mkalkowski83/floor-heating/README.md

# floor-heating

Sterowanie ogrzewaniem podłogowym (ESPHome + Home Assistant), moduł przy rozdzielaczach.

## Dokumenty

- Design: [`docs/superpowers/specs/2026-10-30-floor-heating-manifold-design.md`](docs/superpowers/specs/2026-10-30-floor-heating-manifold-design.md)
- Schemat i legenda: [`docs/README-schemat.pl.md`](docs/README-schemat.pl.md) · [PDF](docs/floor-heating-manifold.pdf)
- **BOM (lokalnie):** [`docs/bom/floor-heating-manifold-phase1.xlsx`](docs/bom/floor-heating-manifold-phase1.xlsx) — przenieś na Dysk Google i ewentualnie „Zapisz jako Arkusz Google”
- BOM CSV (opcjonalnie): [`docs/bom/floor-heating-manifold-phase1.csv`](docs/bom/floor-heating-manifold-phase1.csv)
