mkalkowski83/floor-heating/docs/bom/floor-heating-manifold-phase1.csv

Lp | Kategoria | Element | Spec / uwagi | Ilość | Jedn. | Faza | Status | Szac. cena (PLN) | Link / sklep | Uwagi
1 | Sterowanie | ESP32 DevKit V1 | U1. VIN z +5 V płytki AC. GPIO 16, 17, 18, 19, 21, 22, 23, 25 = zawory; 26 = pompa; 27 = HD; 4 = 1-Wire. | 1 | szt. | kupiony | kupiony |  |  | Aktywne LOW. Przy programowaniu nie łączyć USB z +5 V HLK.
2 | Sterowanie | Moduł 8 przekaźników 5 V | U2. Optoizolacja, zworka JD-VCC–VCC do zdjęcia. Styki NO 10 A. K1–K8 siłowniki 230 V NC. | 1 | szt. | kupić | do zakupu |  |  | VCC przy IN = 3,3 V z ESP. Cewki z +5 V (JD-VCC).
3 | Sterowanie | Moduł 2 przekaźniki 5 V | U3. Ten sam typ co U2. K9 pompa (rezerwa), K10 suchy styk RT. | 1 | szt. | kupić | do zakupu |  |  | K10 bez 230 V. Nie używać Burner off.
4 | Zasilanie AC | HLK-10M05 | PS1. 5 V / 2 A / 10 W, 85–264 V AC. | 1 | szt. | kupiony | kupiony |  |  | Nie HLK-PM01 (3 W) i nie HLK-2M05 ze szamba — za mało prądu na 10 cewek.
5 | Zasilanie AC | Bezpiecznik T1A zwłoczny + oprawka | F1. Tylko tor HLK, przed modułem. | 1 | kpl. | kupić | do zakupu |  |  | Odpowiednik F1 (~1 A) z płytki AC w szambie.
6 | Zasilanie AC | Warystor MOV, L–N | Na płytce AC, równolegle do wejścia HLK. 275 V AC, typowo 10D471K albo 14D471K. | 1 | szt. | kupić | do zakupu |  |  | Jak RV1 w tank-level-mains. Na schemacie podłogówki jeszcze go nie ma.
7 | Zasilanie AC | Zacisk śrubowy 2P, L/N | Wejście płytki AC. | 1 | szt. | kupić | do zakupu |  |  | Jak J1 na płytce AC w szambie. To wejście 230 V modułu.
8 | Zasilanie AC | Zacisk śrubowy 2P, +5 V / GND | Wyjście płytki AC: VIN ESP oraz JD-VCC obu modułów przekaźników. | 1 | szt. | kupić | do zakupu |  |  | Jak J2 w szambie. GND logiki nie łączyć z N sieci.
9 | Zasilanie AC | Płytka uniwersalna AC | Osobna od logiki. Odstępy sieciowe tylko na tej płytce. | 1 | szt. | kupić | do zakupu |  |  | Układ jak w szambie: L/N → F1 → MOV → HLK-10M05 → +5 V/GND.
10 | Zasilanie AC | Kondensator ceramiczny 100 nF / 50 V | Osiowy, monolityczny. C1 przy +5 V/GND wyjścia HLK (PS1), C2 przy VIN ESP (U1). Nie X2 — tylko 5 V. | 2 | szt. | kupić | do zakupu |  | https://allegro.pl/oferta/kondensator-monolityczny-100nf-50v-osiowy-10szt-12324094122 | Paczka 10 szt. na Allegro. Nie pod 230 V / nie kondensator X2.
11 | Obciążenie | Bezpiecznik T2A zwłoczny + oprawka | F2. Faza L_OBC siłowników i pompy. | 1 | kpl. | kupić | do zakupu |  |  | Nie zasila HLK.
12 | Obciążenie | Listwa N_OBC, 9 pól + mostek | J12–J19: kabel do pinu 2 ZAW1–ZAW8. J20: kabel do pinu 2 pompy. Drugi biegun pól zwarty w jedną linię N_OBC. | 1 | kpl. | kupić | do zakupu |  |  | Neutral z wejścia 230 V.
13 | Obciążenie | Listwa L_OBC, 9 pól + mostek | J21–J28: kabel na COM K1–K8. J29: kabel na COM K9. Drugi biegun pól zwarty w jedną linię L_OBC. | 1 | kpl. | kupić | do zakupu |  |  | K10 (RT) nie wchodzi na tę listwę.
14 | Obciążenie | Zacisk śrubowy 2P siłownika | J2–J9. Pin 1 = styk NO przekaźnika, pin 2 = kabel do listwy N. | 8 | szt. | kupić | do zakupu |  |  | W fazie 1 podłączone 3–4 pętle; zaciski od razu pod 8.
15 | Obciążenie | Zacisk śrubowy 2P pompy | J10. Pin 1 = NO K9, pin 2 = listwa N. | 1 | szt. | kupić | do zakupu |  |  | Samej pompy i sprzęgła nie kupować w fazie 1.
16 | Obciążenie | Zacisk śrubowy 2P RT | J11. Suchy styk NO–COM na zacisk RT kotła VC 15CS/1-5. | 1 | szt. | kupić | do zakupu |  |  | Bez 230 V. Nie Burner off.
17 | Siłowniki | Siłownik termoelektryczny 230 V NC | Gwint jak na rozdzielaczu (często M30×1.5). NC: zasilony = zawór otwarty. | 4 | szt. | kupić | do zakupu |  |  | Docelowo do 8.
18 | Przyłącza | Kabel HD → Vaillant | Suchy styk modułu na zacisk RT. | 1 | kpl. | kupić | do zakupu |  |  | eBUS zostaje głównym żądaniem ciepła.
19 | Przyłącza | Przewody, tulejki, oznaczniki | 230 V: 0,75–1,5 mm². +5 V i 1-Wire: cieńszy przewód. Tulejki i numerki. | 1 | kpl. | kupić | do zakupu
20 | Obudowa | Obudowa modułu | Mieści płytkę AC z HLK i część logiczną. HLK w zamkniętej części obudowy. | 1 | szt. | kupić | do zakupu |  |  | Zapas na listwy L/N i 1-Wire.
21 | Temperatura | DS18B20, sonda Ø ~6 mm | U4 zasilanie rozdzielacza, U5 powrót. Przewód 1–2 m. | 2 | szt. | kupić | do zakupu |  |  | Montaż przylgowy na belkach.
22 | Temperatura | Montaż przylgowy | Opaski, pasta termoprzewodząca, izolacja. | 2 | kpl. | kupić | do zakupu |  |  | Bazowy montaż.
23 | Temperatura | Rezystor 4,7 kΩ | R1. Pull-up magistrali 1-Wire do 3,3 V. | 1 | szt. | kupić | do zakupu
24 | Instalacja | RCBO obwodu modułu | 1P+N, 30 mA typ A, prąd znamionowy wg elektryka. W rozdzielnicy, nie na płytce AC. | 1 | szt. | kupić | do ustalenia |  |  | Nie zastępuje F1 ani F2.
25 | Temperatura (opcja) | Tuleja zanurzeniowa G½″ | Ø 7–8 mm, L 100–120 mm. Gwint potwierdzić na rozdzielaczu. | 2 | szt. | opcjonalnie | opcja A |  |  | Zamiast montażu przylgowego.
26 | Temperatura (opcja) | Redukcja gwintu | Gdy korek belki nie jest G½″. | 0 | szt. | opcjonalnie | wg rozdzielacza
27 | Temperatura (opcja) | Zachowanie spustu belki | Trójnik albo drugi spust, jeśli tuleja zajmuje jedyny. | 0 | kpl. | opcjonalnie | wg rozdzielacza
28 | Rezerwa | Pompa wtórna i sprzęgło | Kanał K9, J10 i J29 są na liście. Samej pompy nie kupować. | 0 | — | nie kupować | n/d |  |  | Osobna decyzja z hydraulikiem.
29 | Out | Zigbee na sterowniku | Odrzucone. Moduł jest na Wi-Fi, sieć IoT bez WAN. | 0 | — | nie kupować | nie kupować
30 | Docelowo | Moduł dół | Kopia pozycji kupowanych dla modułu góra, łącznie z płytką AC. | 0 | — | odłożone | odłożone
