mkalkowski83/floor-heating/docs/floor-heating-manifold.pdf

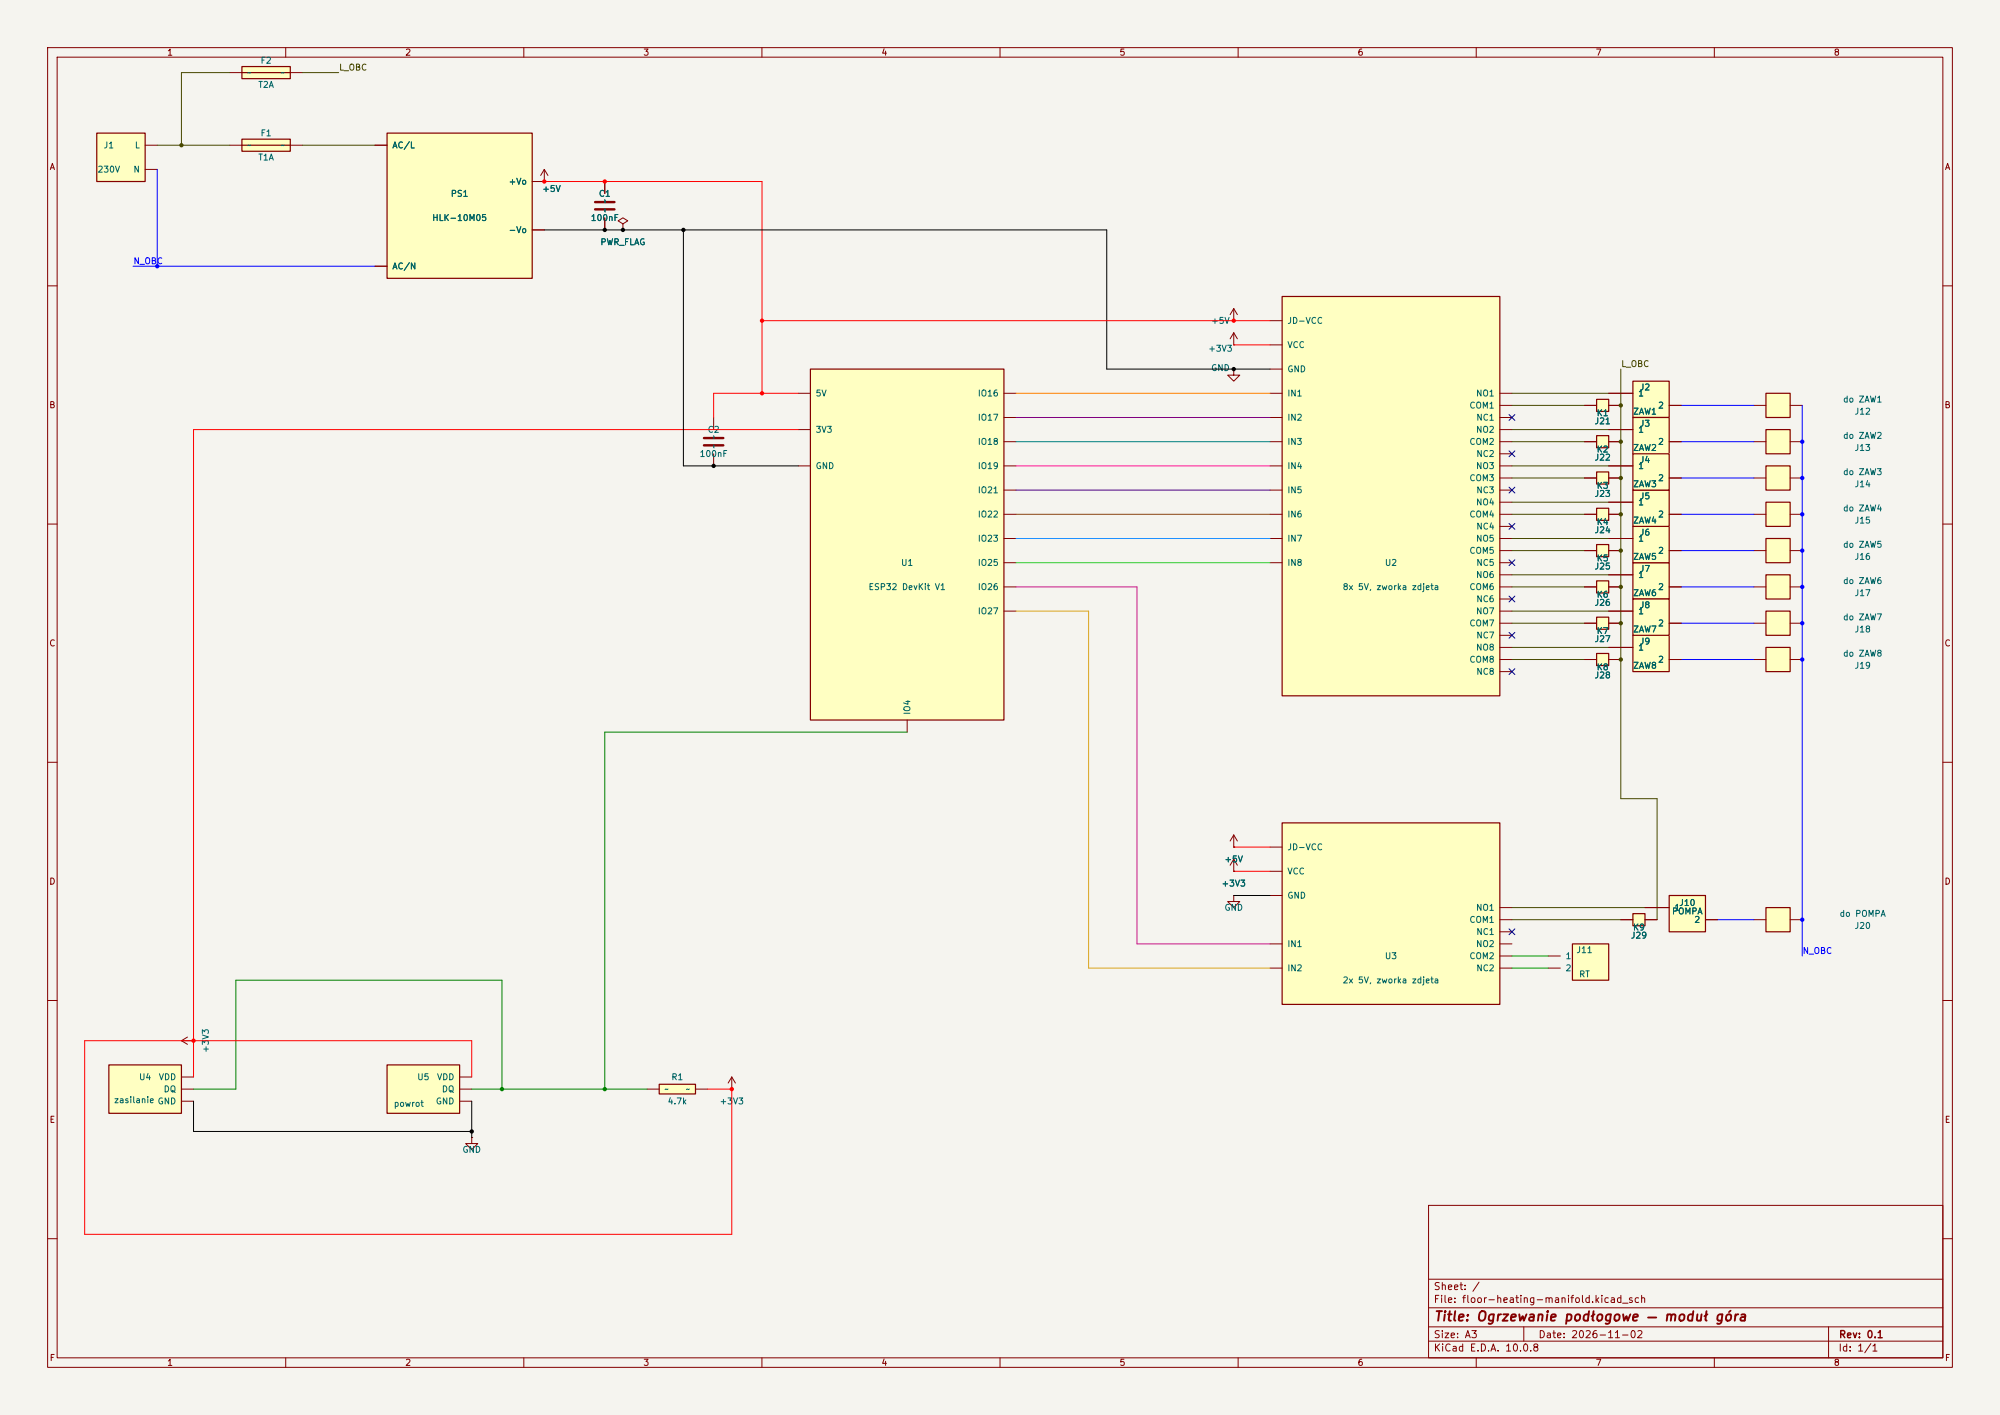
[picture p1: page 1]

File: floor-heating-manifold.kicad_sch
Title: Ogrzewanie podłogowe — moduł góra

Size: A3 | Rev: 0.1 | F Date: 2026-11-02
KiCad E.D.A. 10.0.8 | Id: 1/1
