mkalkowski83/floor-heating/docs/kicad/floor-heating-manifold/floor-heating-manifold.kicad_sch

## KiCad design docs/kicad/floor-heating-manifold/floor-heating-manifold.kicad_sch (2026-11-10)

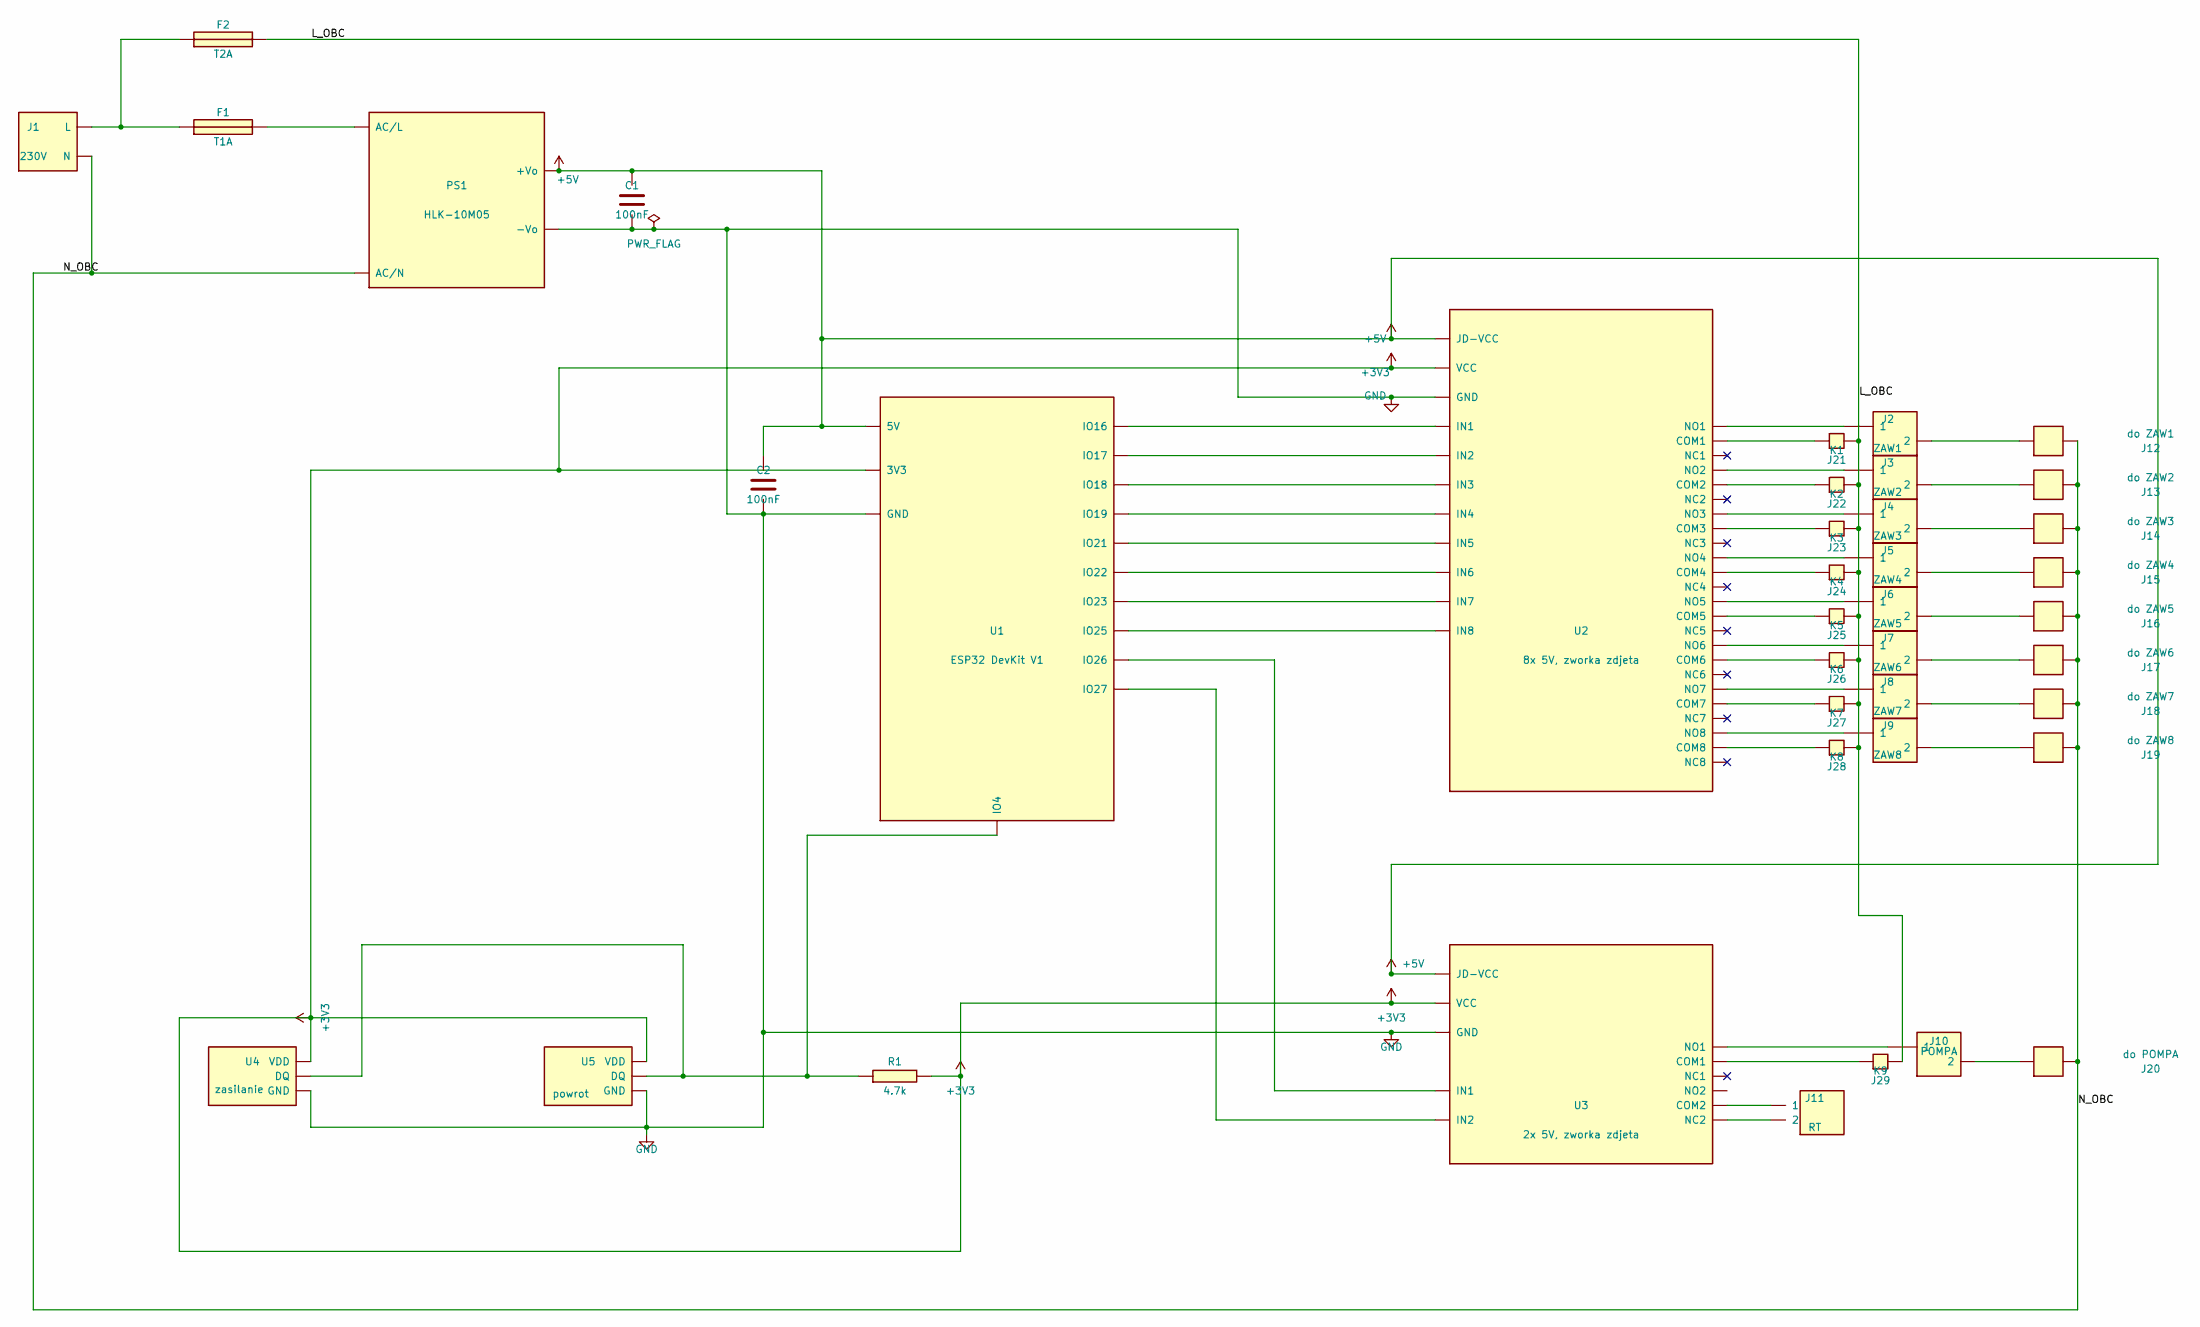
[picture p2: schematic floor-heating-manifold.kicad_sch]

Parts:
C1, C2: 100nF
F1: T1A
F2: T2A
J1: 230V
J2: ZAW1
J3: ZAW2
J4: ZAW3
J5: ZAW4
J6: ZAW5
J7: ZAW6
J8: ZAW7
J9: ZAW8
J10: POMPA
J11: RT
J12: do ZAW1
J13: do ZAW2
J14: do ZAW3
J15: do ZAW4
J16: do ZAW5
J17: do ZAW6
J18: do ZAW7
J19: do ZAW8
J20: do POMPA
J21: K1
J22: K2
J23: K3
J24: K4
J25: K5
J26: K6
J27: K7
J28: K8
J29: K9
PS1: HLK-10M05
R1: 4.7k
U1: ESP32 DevKit V1
U2: 8x 5V, zworka zdjeta
U3: 2x 5V, zworka zdjeta
U4: zasilanie
U5: powrot

Connections:
+3V3: R1.2, U1.2 (3V3), U2.2 (VCC), U3.2 (VCC), U4.1 (VDD), U5.1 (VDD)
+5V: C1.1, C2.1, PS1.3 (+Vo), U1.1 (5V), U2.1 (JD-VCC), U3.1 (JD-VCC)
GND: C1.2, C2.2, PS1.4 (-Vo), U1.3 (GND), U2.3 (GND), U3.3 (GND), U4.3 (GND), U5.3 (GND)
L_OBC: F2.2, J21.2, J22.2, J23.2, J24.2, J25.2, J26.2, J27.2, J28.2, J29.2
N_OBC: J1.2 (N), J12.2, J13.2, J14.2, J15.2, J16.2, J17.2, J18.2, J19.2, J20.2, PS1.2 (AC/N)
unnamed: F1.1, F2.1, J1.1 (L)
unnamed: F1.2, PS1.1 (AC/L)
unnamed: J2.1, U2.12 (NO1)
unnamed: J3.1, U2.15 (NO2)
unnamed: J4.1, U2.18 (NO3)
unnamed: J5.1, U2.21 (NO4)
unnamed: J6.1, U2.24 (NO5)
unnamed: J7.1, U2.27 (NO6)
unnamed: J8.1, U2.30 (NO7)
unnamed: J9.1, U2.33 (NO8)
unnamed: J10.1, U3.6 (NO1)
unnamed: J10.2, J20.1
unnamed: J11.1, U3.10 (COM2)
unnamed: J11.2, U3.11 (NC2)
unnamed: J2.2, J12.1
unnamed: J3.2, J13.1
unnamed: J4.2, J14.1
unnamed: J5.2, J15.1
unnamed: J6.2, J16.1
unnamed: J7.2, J17.1
unnamed: J8.2, J18.1
unnamed: J9.2, J19.1
unnamed: J21.1, U2.13 (COM1)
unnamed: J22.1, U2.16 (COM2)
unnamed: J23.1, U2.19 (COM3)
unnamed: J24.1, U2.22 (COM4)
unnamed: J25.1, U2.25 (COM5)
unnamed: J26.1, U2.28 (COM6)
unnamed: J27.1, U2.31 (COM7)
unnamed: J28.1, U2.34 (COM8)
unnamed: J29.1, U3.7 (COM1)
unnamed: R1.1, U1.14 (IO4), U4.2 (DQ), U5.2 (DQ)
unnamed: U1.4 (IO16), U2.4 (IN1)
unnamed: U1.5 (IO17), U2.5 (IN2)
unnamed: U1.6 (IO18), U2.6 (IN3)
unnamed: U1.7 (IO19), U2.7 (IN4)
unnamed: U1.8 (IO21), U2.8 (IN5)
unnamed: U1.9 (IO22), U2.9 (IN6)
unnamed: U1.10 (IO23), U2.10 (IN7)
unnamed: U1.11 (IO25), U2.11 (IN8)
unnamed: U1.12 (IO26), U3.4 (IN1)
unnamed: U1.13 (IO27), U3.5 (IN2)
