mkalkowski83/floor-heating/(commit log)

2026-10-30 Add manifold control design spec and phase-1 BOM.
    Lock architecture for upstairs ESPHome actor, Vaillant HD/eBUS, and deferred pump/Zigbee options.
    [floor-heating-manifold-phase1.xlsx]
2026-11-10 Schemat KiCad: ESP32, HLK-10M05 i przekaźniki 8+2 (#2)
    * Add the KiCad wiring schematic for the upstairs manifold module.
    ESP32, HLK-10M05 and the 8+2 relay boards share one 5 V rail for the coils, while the optocoupler VCC stays on 3.3 V.
    * add plot file
    The PDF is an export of the upstairs manifold sheet. The legend names each reference, including F1 for the HLK and F2 for the actuator loads.
    * Point the schematic legend at the exported PDF.
    The parts legend sits next to docs/floor-heating-manifold.pdf and the duplicate plot is removed.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
    [floor-heating-manifold-phase1-uwagi.csv, floor-heating-manifold-phase1.csv, floor-heating-manifold-phase1.xlsx, floor-heating-manifold.kicad_sch]
